MeesCode/gameboy-pcb/custom/models/wuerth_434133025816.stp

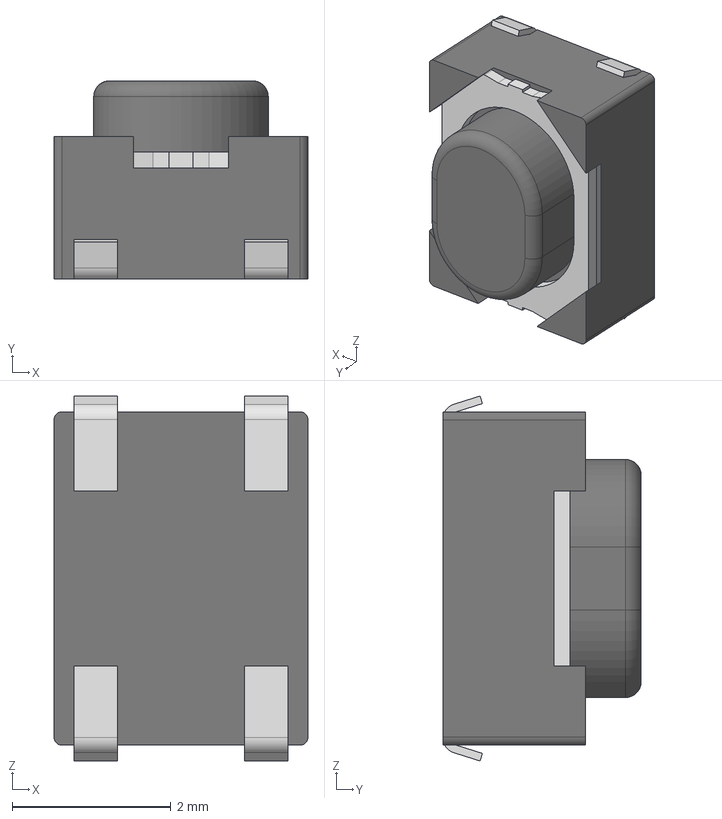
[picture p1: CAD file, 2026-01-30]
custom/models/wuerth_434133025816.stp
3.20 x 2.50 x 4.60 mm
Frame
Cover
Stem
Terminal x 4
