MeesCode/gameboy-pcb/gameboy.step

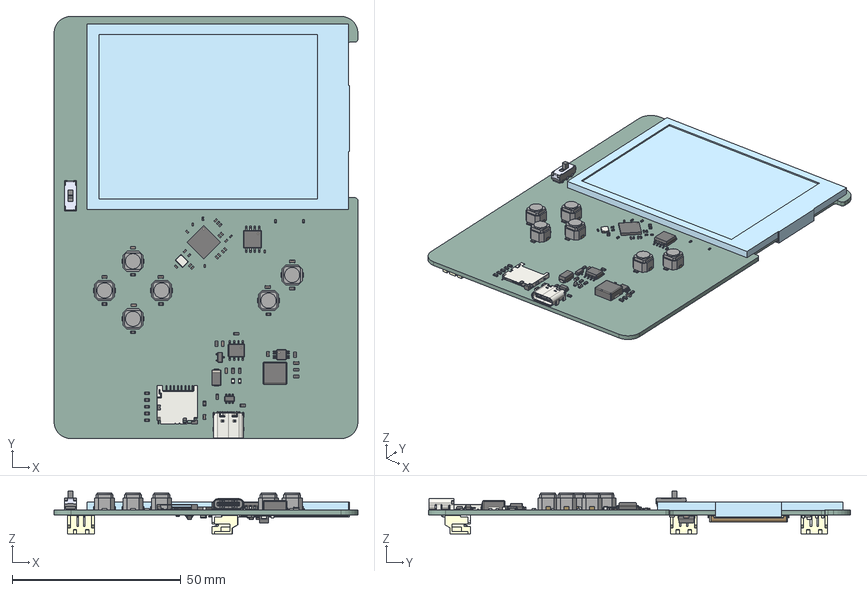
[picture p2: CAD file, 2026-01-30]
gameboy.step
90.0 x 125.0 x 12.7 mm
MSOP-8_3x3mm_P0.65mm
R_0402_1005Metric x 7
R_0603_1608Metric x 28
JS202011JCQN
C_0402_1005Metric x 17
C_0603_1608Metric x 16
pin_1 x 6
pin_2 x 6
SOIC-8_5.3x5.3mm_P1.27mm
LED_0603_1608Metric x 2
SO-8_3.9x4.9mm_P1.27mm
D_SMA x 2
QFN-56-1EP_7x7mm_P0.4mm_EP5.6x5.6mm
Crystal_SMD_3225-4Pin_3.2x2.5mm
microSD_HC_Hirose_DM3D-SF
USB_C_Receptacle_GCT_USB4105-xx-A_16P_TopMnt_Horizontal
SOT-23 x 3
SOT-23-6
L_KOHERelec_MDA7030
lock
pins
LCD
S2B-PH-SM4-TB x 3
L_0603_1608Metric x 2
C_0805_2012Metric
gameboy_PCB
