MeesCode/gameboy-pcb/custom/models/LDC.step

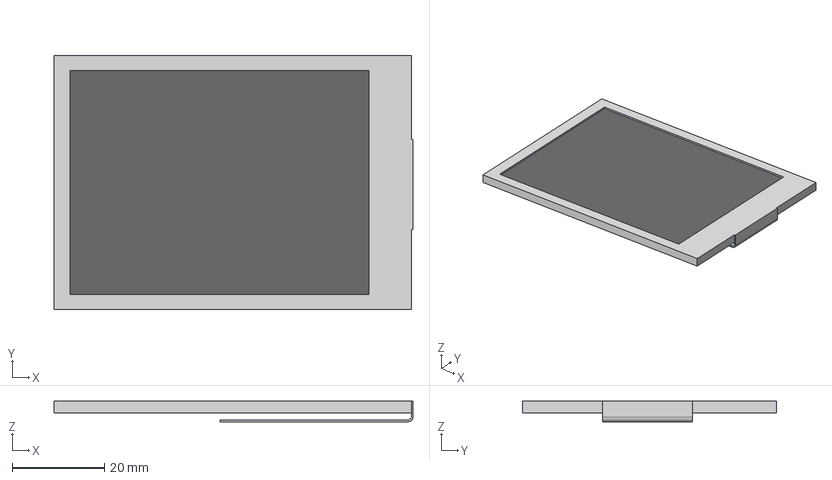
[picture p3: CAD file, 2026-01-30]
custom/models/LDC.step
77.8 x 55.0 x 4.45 mm
