MeesCode/gameboy-pcb/custom/models/SM03B-SRSS-TB_LF__SN_.stp

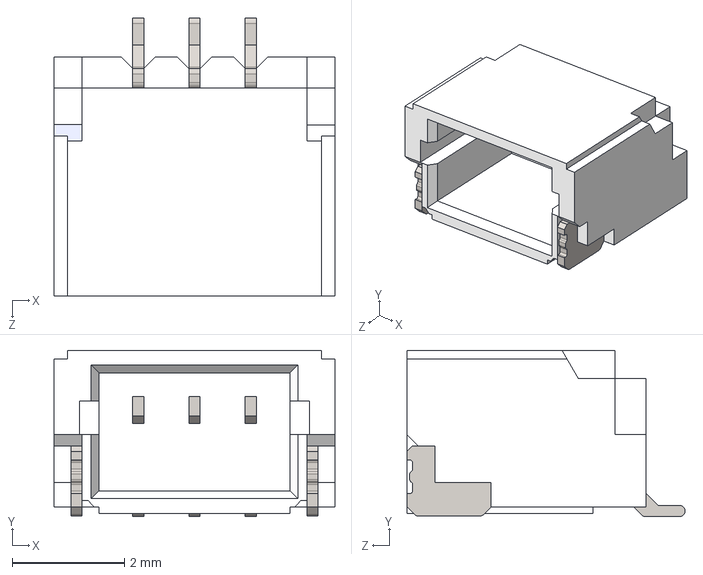
[picture p4: CAD file, 2026-01-30]
custom/models/SM03B-SRSS-TB_LF__SN_.stp
5.00 x 2.96 x 4.95 mm
