MeesCode/gameboy-pcb/custom/models/S2B-PH-SM4-TB.STEP

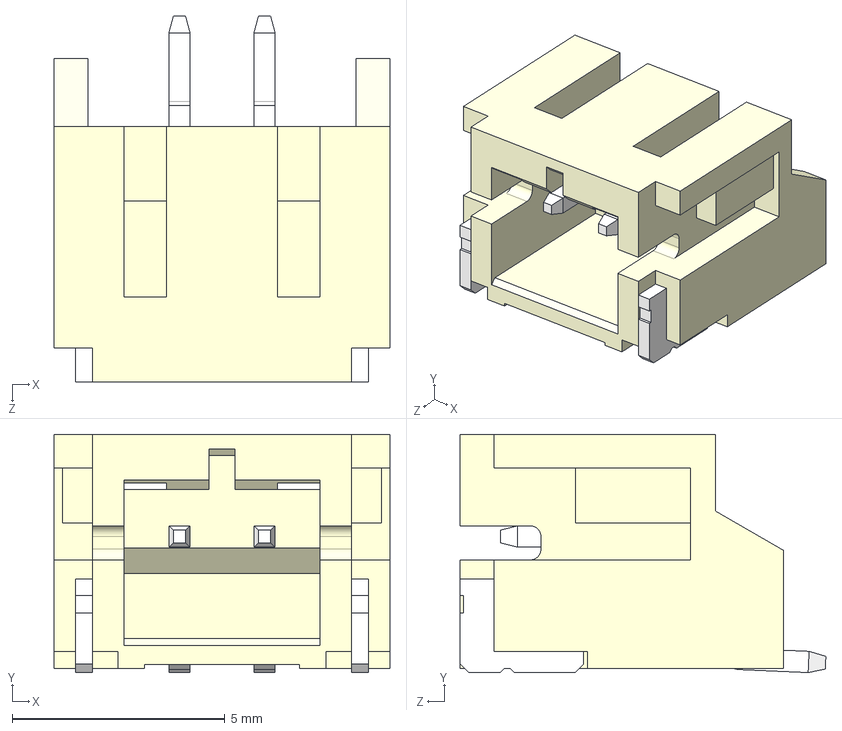
[picture p5: CAD file, 2026-01-20]
custom/models/S2B-PH-SM4-TB.STEP
7.90 x 5.60 x 8.60 mm
