MeesCode/gameboy-pcb/custom/models/RP2350_QFN60.step

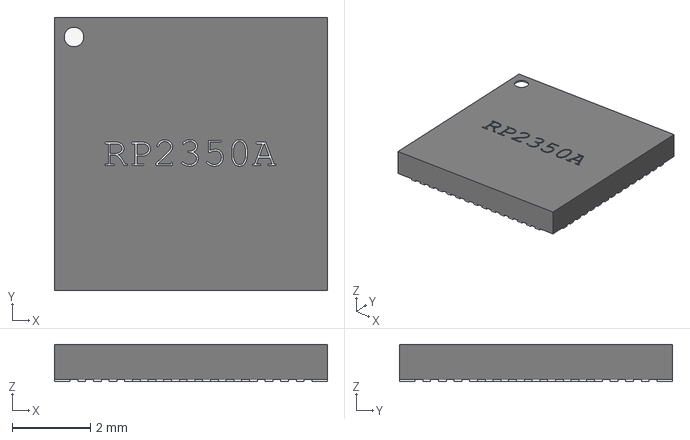
[picture p6: CAD file, 2026-01-10]
custom/models/RP2350_QFN60.step
7.00 x 7.00 x 0.95 mm
