MeesCode/gameboy-pcb/custom/models/SKRRAAE010.stp

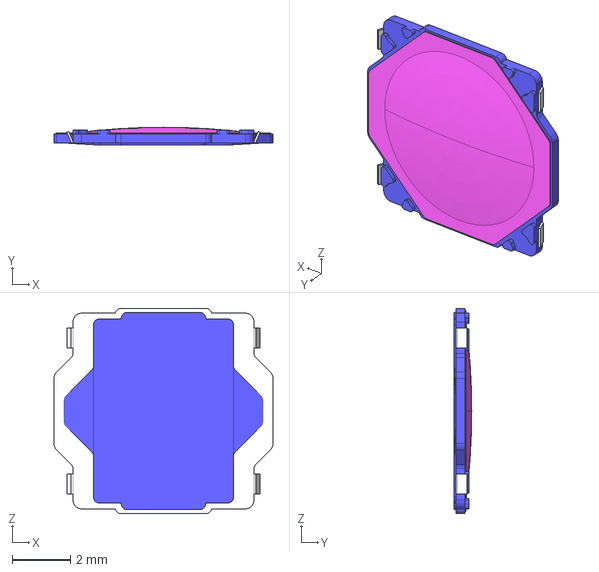
[picture p7: CAD file, 2025-12-01]
custom/models/SKRRAAE010.stp
7.50 x 0.6 x 7.03 mm
