MeesCode/gameboy-pcb/custom/models/JS202011JCQN.STEP

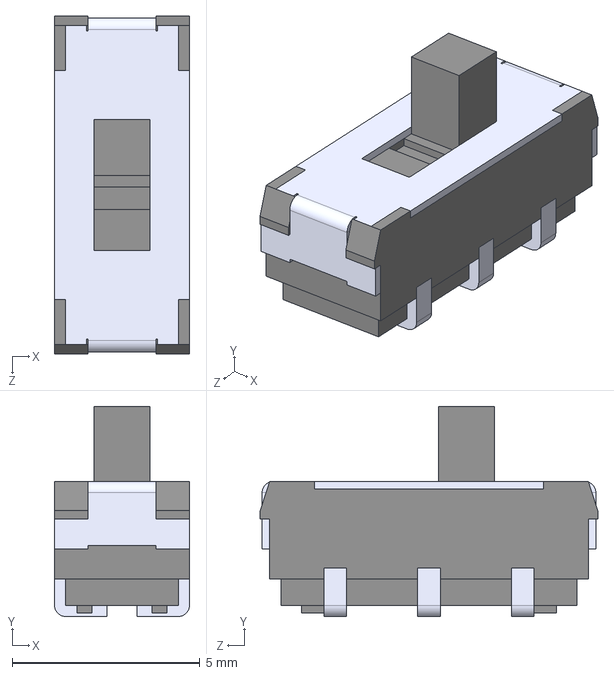
[picture p8: CAD file, 2026-01-30]
custom/models/JS202011JCQN.STEP
3.60 x 5.60 x 9.00 mm
