MeesCode/gameboy-pcb/gameboy.kicad_pcb

## KiCad design gameboy.kicad_pcb (2026-10-22)

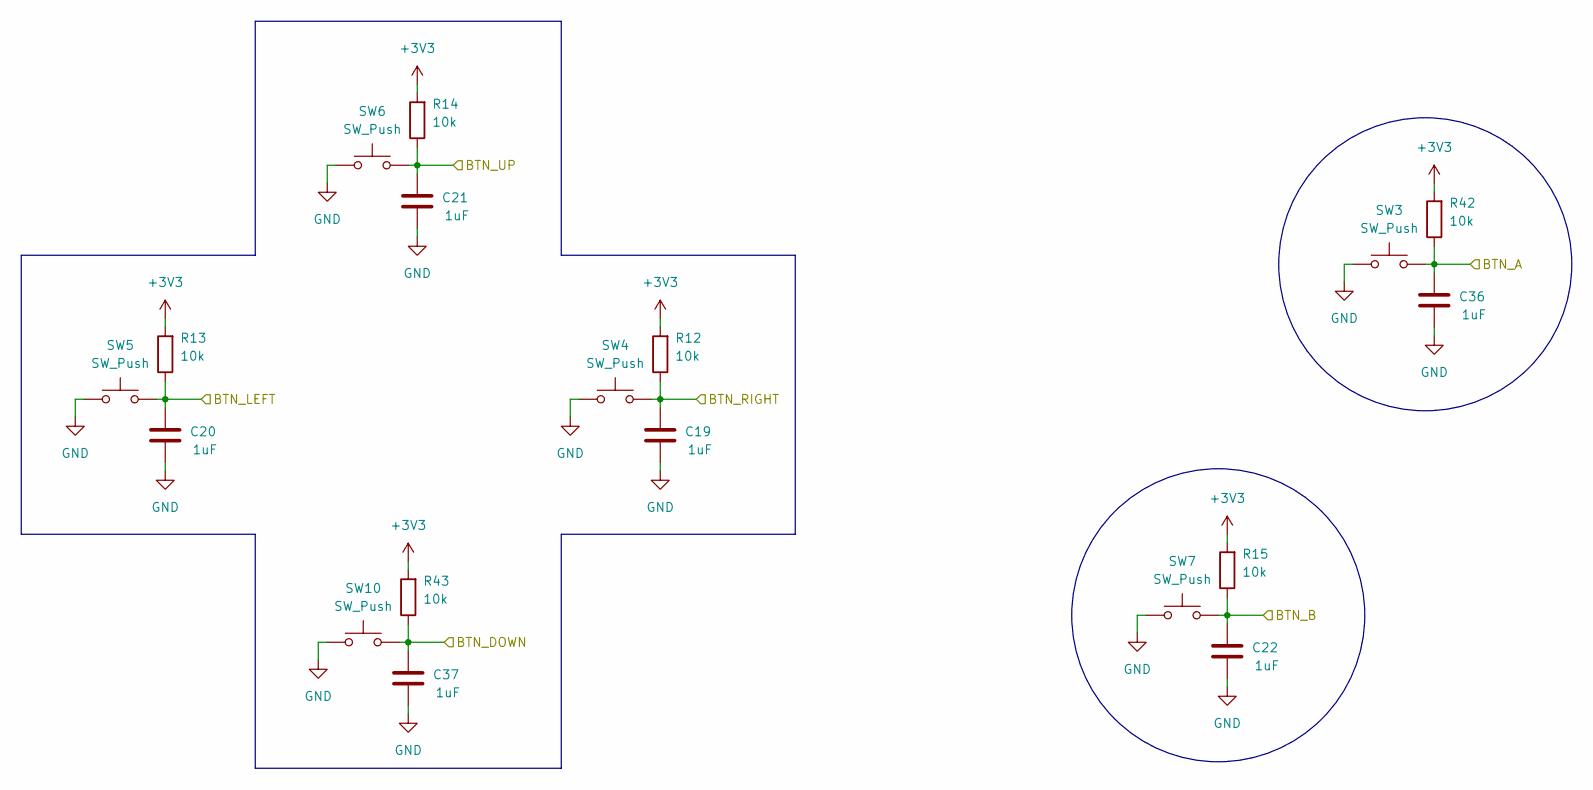
[picture p9: schematic buttons.kicad_sch]

Parts:
C19, C20, C21, C22, C36, C37: 1uF; C_0402_1005Metric; Manufacturer Part Number CL05A105KA5NQNC; LCSC C52923
R12, R13, R14, R15, R42, R43: 10k; R_0603_1608Metric
SW3, SW4, SW5, SW6, SW7, SW10: SW_Push; SW_Push_1TS009xxxx-xxxx-xxxx_6x6x5mm; Manufacturer Part Number HX TS665WS 200gf; LCSC C5143657

Connections:
+3V3: R12.2, R13.2, R14.2, R15.2, R42.2, R43.2; also elsewhere on the board
/Buttons/BTN_A: C36.2, R42.1, SW3.2; also elsewhere on the board
/Buttons/BTN_B: C22.2, R15.1, SW7.2; also elsewhere on the board
/Buttons/BTN_DOWN: C37.2, R43.1, SW10.2; also elsewhere on the board
/Buttons/BTN_LEFT: C20.2, R13.1, SW5.2; also elsewhere on the board
/Buttons/BTN_RIGHT: C19.2, R12.1, SW4.2; also elsewhere on the board
/Buttons/BTN_UP: C21.2, R14.1, SW6.2; also elsewhere on the board
GND: C19.1, C20.1, C21.1, C22.1, C36.1, C37.1, SW3.1, SW4.1, SW5.1, SW6.1, SW7.1, SW10.1; also elsewhere on the board

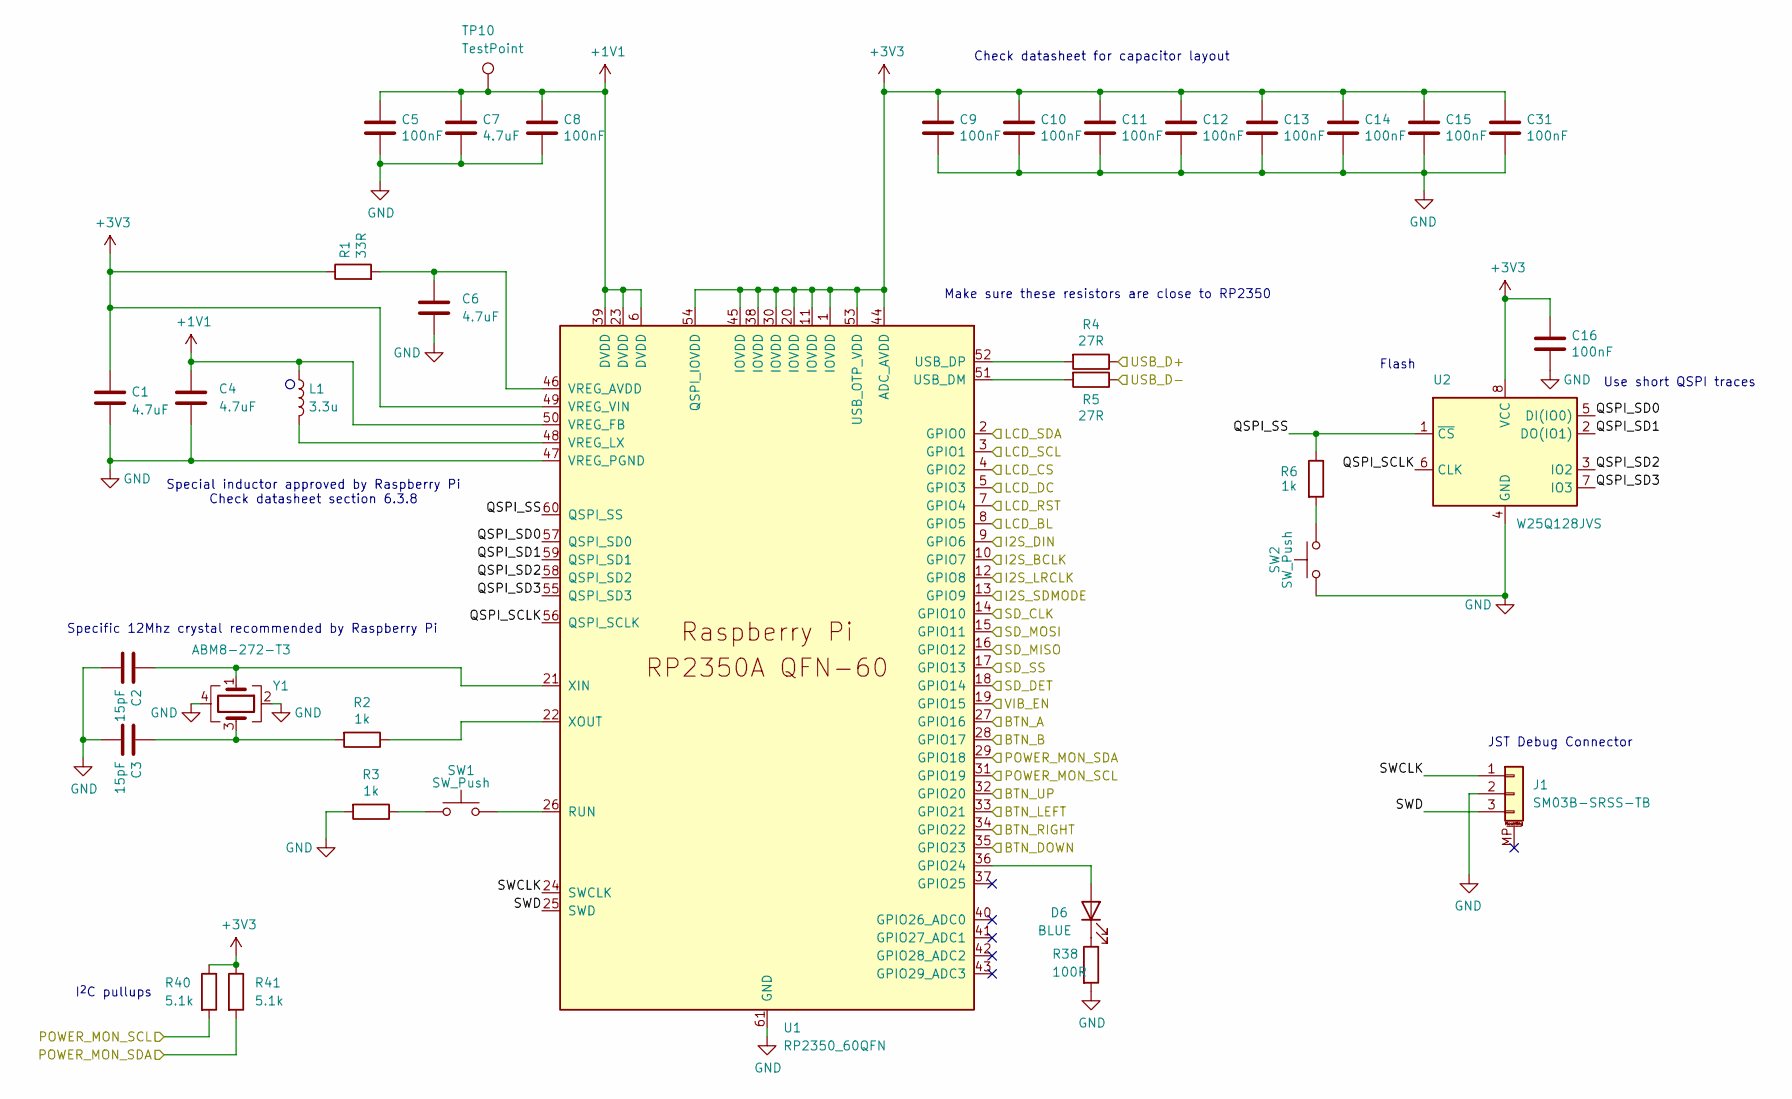
[picture p10: schematic mcu.kicad_sch]

Parts:
C1, C4, C6, C7: 4.7uF; C_0402_1005Metric
C2, C3: 15pF; C_0402_1005Metric
C5, C8, C9, C10, C11, C12, C13, C14, C15, C16, C31: 100nF; C_0402_1005Metric
D6: BLUE; LED_Sideways; Manufacturer Part Number XL-1606UBC; LCSC C965865
J1: SM03B-SRSS-TB; JST_SH_SM03B-SRSS-TB_1x03-1MP_P1.00mm_Horizontal; LCSC C160403
L1: 3.3u; L_pol_2016; Manufacturer Part Number AOTA-B201610S3R3-101-T; LCSC C42411119
R1: 33R; R_0402_1005Metric
R2, R3, R6: 1k; R_0603_1608Metric
R4, R5: 27R; R_0402_1005Metric
R38: 100R; R_0603_1608Metric; Manufacturer Part Number 0603WAF1000T5E; LCSC C22775
R40, R41: 5.1k; R_0603_1608Metric
SW1, SW2: SW_Push; SW_Push_1P1T_NO_Vertical_Wuerth_434133025816; Manufacturer Part Number 434133025816; LCSC C843674
TP10: TestPoint; TestPoint_Pad_D1.0mm
U1: RP2350_60QFN; RP2350-QFN-60-1EP_7x7_P0.4mm_EP3.4x3.4mm_ThermalVias; Manufacturer Part Number RP2350A; LCSC C42411118
U2: W25Q128JVS; SOIC-8_5.3x5.3mm_P1.27mm; Manufacturer Part Number W25Q128JVSIQ; LCSC C113767
Y1: ABM8-272-T3; Crystal_SMD_3225-4Pin_3.2x2.5mm; Manufacturer Part Number ABM8-272-T3; LCSC C20625731

Connections:
+1V1: C4.1, C5.1, C7.1, C8.1, L1.1, TP10.1 (1_1), U1.6 (DVDD), U1.23 (DVDD), U1.39 (DVDD), U1.50 (VREG_FB)
+3V3: C1.1, C9.1, C10.1, C11.1, C12.1, C13.1, C14.1, C15.1, C16.1, C31.1, R1.1, R40.1, R41.1, U1.1 (IOVDD), U1.11 (IOVDD), U1.20 (IOVDD), U1.30 (IOVDD), U1.38 (IOVDD), U1.44 (ADC_AVDD), U1.45 (IOVDD), U1.49 (VREG_VIN), U1.53 (USB_OTP_VDD), U1.54 (QSPI_IOVDD), U2.8 (VCC); also elsewhere on the board
/Audio/I2S_BCLK: U1.10 (GPIO7); also elsewhere on the board
/Audio/I2S_DIN: U1.9 (GPIO6); also elsewhere on the board
/Audio/I2S_LRCLK: U1.12 (GPIO8); also elsewhere on the board
/Audio/I2S_SDMODE: U1.13 (GPIO9); also elsewhere on the board
/Buttons/BTN_A: U1.27 (GPIO16); also elsewhere on the board
/Buttons/BTN_B: U1.28 (GPIO17); also elsewhere on the board
/Buttons/BTN_DOWN: U1.35 (GPIO23); also elsewhere on the board
/Buttons/BTN_LEFT: U1.33 (GPIO21); also elsewhere on the board
/Buttons/BTN_RIGHT: U1.34 (GPIO22); also elsewhere on the board
/Buttons/BTN_UP: U1.32 (GPIO20); also elsewhere on the board
/LCD/LCD_BL: U1.8 (GPIO5); also elsewhere on the board
/LCD/LCD_CS: U1.4 (GPIO2); also elsewhere on the board
/LCD/LCD_DC: U1.5 (GPIO3); also elsewhere on the board
/LCD/LCD_RST: U1.7 (GPIO4); also elsewhere on the board
/LCD/LCD_SCL: U1.3 (GPIO1); also elsewhere on the board
/LCD/LCD_SDA: U1.2 (GPIO0); also elsewhere on the board
/MCU/POWER_MON_SCL: R40.2, U1.31 (GPIO19); also elsewhere on the board
/MCU/POWER_MON_SDA: R41.2, U1.29 (GPIO18); also elsewhere on the board
/MCU/QSPI_SCLK: U1.56 (QSPI_SCLK), U2.6 (CLK)
/MCU/QSPI_SD0: U1.57 (QSPI_SD0), U2.5 (DI(IO0))
/MCU/QSPI_SD1: U1.59 (QSPI_SD1), U2.2 (DO(IO1))
/MCU/QSPI_SD2: U1.58 (QSPI_SD2), U2.3 (IO2)
/MCU/QSPI_SD3: U1.55 (QSPI_SD3), U2.7 (IO3)
/MCU/QSPI_SS: R6.1, U1.60 (QSPI_SS), U2.1 (~CS)
/MCU/SD_CLK: U1.14 (GPIO10); also elsewhere on the board
/MCU/SD_DET: U1.18 (GPIO14); also elsewhere on the board
/MCU/SD_MISO: U1.16 (GPIO12); also elsewhere on the board
/MCU/SD_MOSI: U1.15 (GPIO11); also elsewhere on the board
/MCU/SD_SS: U1.17 (GPIO13); also elsewhere on the board
/MCU/SWCLK: J1.1, U1.24 (SWCLK)
/MCU/SWD: J1.3, U1.25 (SWD)
/MCU/USB_D+: R4.1; also elsewhere on the board
/MCU/USB_D-: R5.1; also elsewhere on the board
/MCU/VIB_EN: U1.19 (GPIO15); also elsewhere on the board
GND: C1.2, C2.2, C3.2, C4.2, C5.2, C6.2, C7.2, C8.2, C9.2, C10.2, C11.2, C12.2, C13.2, C14.2, C15.2, C16.2, C31.2, J1.2, R3.2, R38.2, SW2.1, U1.47 (VREG_PGND), U1.61 (GND), U2.4 (GND), Y1.2, Y1.4; also elsewhere on the board
unnamed: C3.1, R2.2, Y1.3
unnamed: D6.2 (A), U1.36 (GPIO24)
unnamed: D6.1 (K), R38.1
unnamed: R3.1, SW1.1
unnamed: R6.2, SW2.2
unnamed: SW1.2, U1.26 (RUN)
unnamed: R5.2, U1.51 (USB_DM)
unnamed: R4.2, U1.52 (USB_DP)
unnamed: C6.1, R1.2, U1.46 (VREG_AVDD)
unnamed: L1.2, U1.48 (VREG_LX)
unnamed: C2.1, U1.21 (XIN), Y1.1
unnamed: R2.1, U1.22 (XOUT)

Notes on the sheet:
Check datasheet for capacitor layout
Special inductor approved by Raspberry Pi Check datasheet section 6.3.8
Specific 12Mhz crystal recommended by Raspberry Pi
Use short QSPI traces
Make sure these resistors are close to RP2350
Flash
I^{2}C pullups
JST Debug Connector

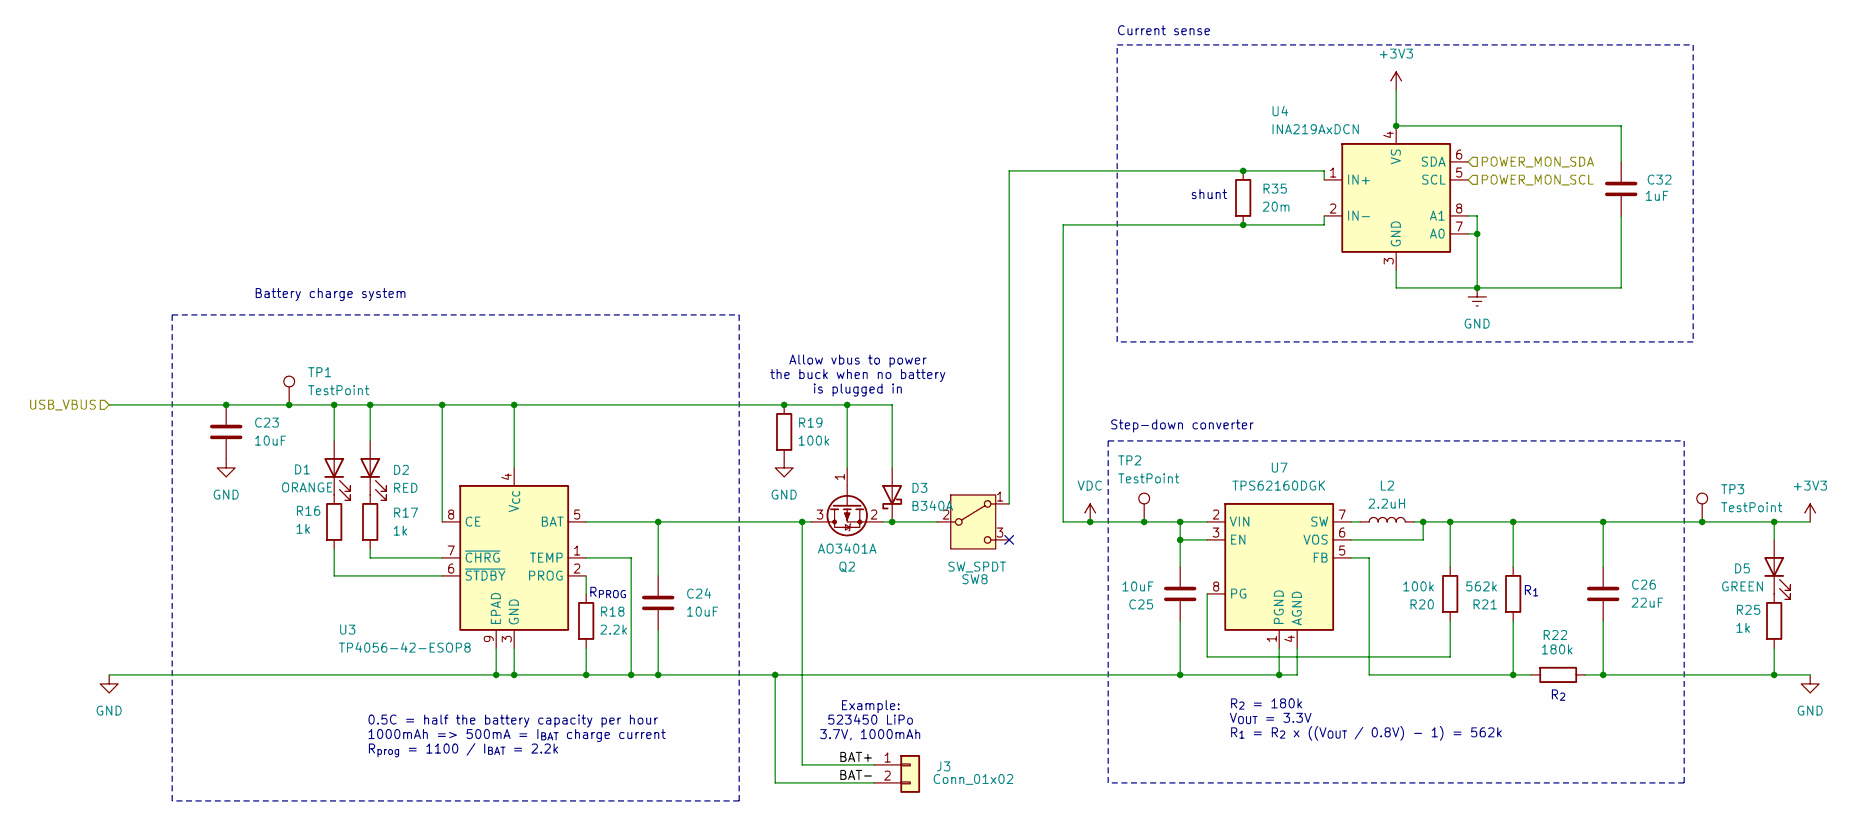
[picture p11: schematic power.kicad_sch]

Parts:
C23, C24, C25: 10uF; C_0805_2012Metric
C26: 22uF; C_0603_1608Metric
C32: 1uF; C_0402_1005Metric; Manufacturer Part Number CL05A105KA5NQNC; LCSC C52923
D1: ORANGE; LED_Sideways; Manufacturer Part Number XL-1606UOC; LCSC C965861
D2: RED; LED_Sideways; Manufacturer Part Number XL-1606SURC; LCSC C965860
D3: B340A; D_SMA; Manufacturer Part Number B340A; LCSC C64982
D5: GREEN; LED_Sideways; Manufacturer Part Number XL-1606SYGC; LCSC C965864
J3: Conn_01x02; JST_PH_S2B-PH-SM4-TB_1x02-1MP_P2.00mm_Horizontal; Manufacturer Part Number S2B-PH-SM4-TB(LF)(SN); LCSC C295747
L2: 2.2uH; L_KOHERelec_MDA7030; Manufacturer Part Number APH0630T2R2M; LCSC C5349701
Q2: AO3401A; SOT-23; Manufacturer Part Number AO3401A; LCSC C347476
R16, R17, R25: 1k; R_0603_1608Metric
R18: 2.2k; R_0603_1608Metric
R19, R20: 100k; R_0603_1608Metric
R21: 562k; R_0603_1608Metric
R22: 180k; R_0603_1608Metric
R35: 20m; R_1206_3216Metric; LCSC C393094
SW8: SW_SPDT; SW_SPDT_CK_JS102011SAQN; Manufacturer Part Number JS102011SAQN; LCSC C221660
TP1, TP2, TP3: TestPoint; TestPoint_Pad_D1.0mm
U3: TP4056-42-ESOP8; SOIC-8-1EP_3.9x4.9mm_P1.27mm_EP2.41x3.3mm_ThermalVias; Manufacturer Part Number TP4056-42-ESOP8; LCSC C16581
U4: INA219AxDCN; SOT-23-8; LCSC C87469
U7: TPS62160DGK; MSOP-8_3x3mm_P0.65mm; Manufacturer Part Number TPS62160DGKR; LCSC C60726

Connections:
+3V3: C26.1, C32.2, D5.2 (A), L2.2, R20.1, R21.1, TP3.1 (1_1), U4.4 (VS), U7.6 (VOS); also elsewhere on the board
/MCU/POWER_MON_SCL: U4.5 (SCL); also elsewhere on the board
/MCU/POWER_MON_SDA: U4.6 (SDA); also elsewhere on the board
/Power/BAT+: C24.1, J3.1, Q2.3 (D), U3.5 (BAT)
/Power/USB_VBUS: C23.1, D1.2 (A), D2.2 (A), D3.2 (A), Q2.1 (G), R19.1, TP1.1 (1_1), U3.4 (V_{CC}), U3.8 (CE); also elsewhere on the board
GND: C23.2, C24.2, C25.2, C26.2, C32.1, J3.2, R18.2, R19.2, R22.1, R25.2, U3.1 (TEMP), U3.3 (GND), U3.9 (EPAD), U4.3 (GND), U4.7 (A0), U4.8 (A1), U7.1 (PGND), U7.4 (AGND); also elsewhere on the board
unnamed: D1.1 (K), R16.1
unnamed: D2.1 (K), R17.1
unnamed: D3.1 (K), Q2.2 (S), SW8.2 (B)
unnamed: D5.1 (K), R25.1
unnamed: R35.1, SW8.1 (A), U4.1 (IN+)
unnamed: R18.1, U3.2 (PROG)
unnamed: R17.2, U3.7 (~CHRG)
unnamed: R16.2, U3.6 (~STDBY)
unnamed: R21.2, R22.2, U7.5 (FB)
unnamed: R20.2, U7.8 (PG)
unnamed: L2.1, U7.7 (SW)
VDC: C25.1, R35.2, TP2.1 (1_1), U4.2 (IN-), U7.2 (VIN), U7.3 (EN)

Notes on the sheet:
shunt
Example: 523450 LiPo 3.7V, 1000mAh
R_{1}
Current sense
R_{2} = 180k V_{OUT} = 3.3V R_{1} = R_{2} x ((V_{OUT} / 0.8V) - 1) = 562k
Battery charge system
R_{PROG}
0.5C = half the battery capacity per hour 1000mAh => 500mA = I_{BAT} charge current R_{prog} = 1100 / I_{BAT} = 2.2k
Allow vbus to power the buck when no battery is plugged in
R_{2}
Step-down converter

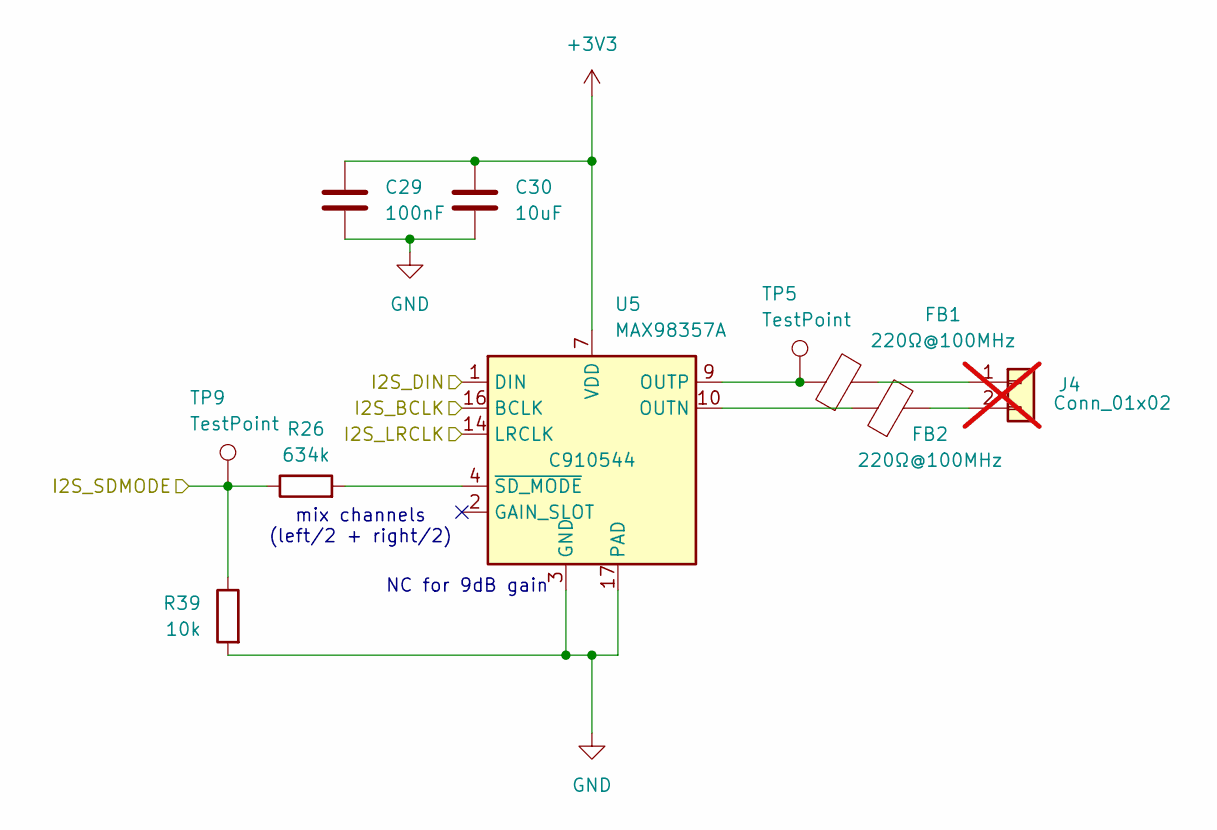
[picture p12: schematic audio.kicad_sch]

Parts:
C29: 100nF; C_0603_1608Metric
C30: 10uF; C_0805_2012Metric
FB1, FB2: 220Ω@100MHz; L_0603_1608Metric; Manufacturer Part Number MPZ1608S221ATA00; LCSC C76815
J4: Conn_01x02; JST_PH_S2B-PH-SM4-TB_1x02-1MP_P2.00mm_Horizontal; Manufacturer Part Number S2B-PH-SM4-TB(LF)(SN); LCSC C295747; not fitted
R26: 634k; R_0603_1608Metric; LCSC C2999499
R39: 10k; R_0603_1608Metric
TP5, TP9: TestPoint; TestPoint_Pad_D1.0mm
U5: MAX98357A; TQFN-16-1EP_3x3mm_P0.5mm_EP1.23x1.23mm; LCSC C910544

Connections:
+3V3: C29.1, C30.1, U5.7 (VDD), U5.8 (VDD); also elsewhere on the board
/Audio/I2S_BCLK: U5.16 (BCLK); also elsewhere on the board
/Audio/I2S_DIN: U5.1 (DIN); also elsewhere on the board
/Audio/I2S_LRCLK: U5.14 (LRCLK); also elsewhere on the board
/Audio/I2S_SDMODE: R26.1, R39.1, TP9.1 (1_1); also elsewhere on the board
GND: C29.2, C30.2, R39.2, U5.3 (GND), U5.11 (GND), U5.15 (GND), U5.17 (PAD); also elsewhere on the board
unnamed: FB1.2, J4.1
unnamed: FB2.2, J4.2
unnamed: FB2.1, U5.10 (OUTN)
unnamed: FB1.1, TP5.1 (1_1), U5.9 (OUTP)
unnamed: R26.2, U5.4 (~SD_MODE)

Notes on the sheet:
mix channels (left/2 + right/2)
NC for 9dB gain

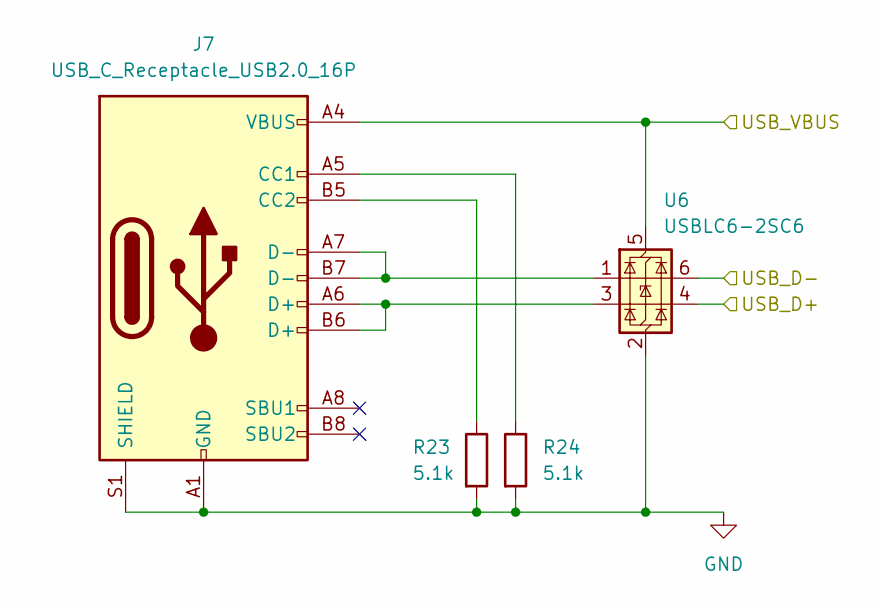
[picture p13: schematic usb.kicad_sch]

Parts:
J7: USB_C_Receptacle_USB2.0_16P; USB_C_Receptacle_GCT_USB4105-xx-A_16P_TopMnt_Horizontal; Manufacturer Part Number TYPE-C 16PIN 2MD(073); LCSC C2765186
R23, R24: 5.1k; R_0603_1608Metric
U6: USBLC6-2SC6; SOT-23-6; Manufacturer Part Number USBLC6-2SC6; LCSC C2827654

Connections:
/MCU/USB_D+: U6.4 (I/O2); also elsewhere on the board
/MCU/USB_D-: U6.6 (I/O1); also elsewhere on the board
/Power/USB_VBUS: J7.A4 (VBUS), J7.A9 (VBUS), J7.B4 (VBUS), J7.B9 (VBUS), U6.5 (VBUS); also elsewhere on the board
GND: J7.A1 (GND), J7.A12 (GND), J7.B1 (GND), J7.B12 (GND), J7.S1 (SHIELD), R23.2, R24.2, U6.2 (GND); also elsewhere on the board
unnamed: J7.A5 (CC1), R24.1
unnamed: J7.B5 (CC2), R23.1
unnamed: J7.A6 (D+), J7.B6 (D+), U6.3 (I/O2)
unnamed: J7.A7 (D-), J7.B7 (D-), U6.1 (I/O1)

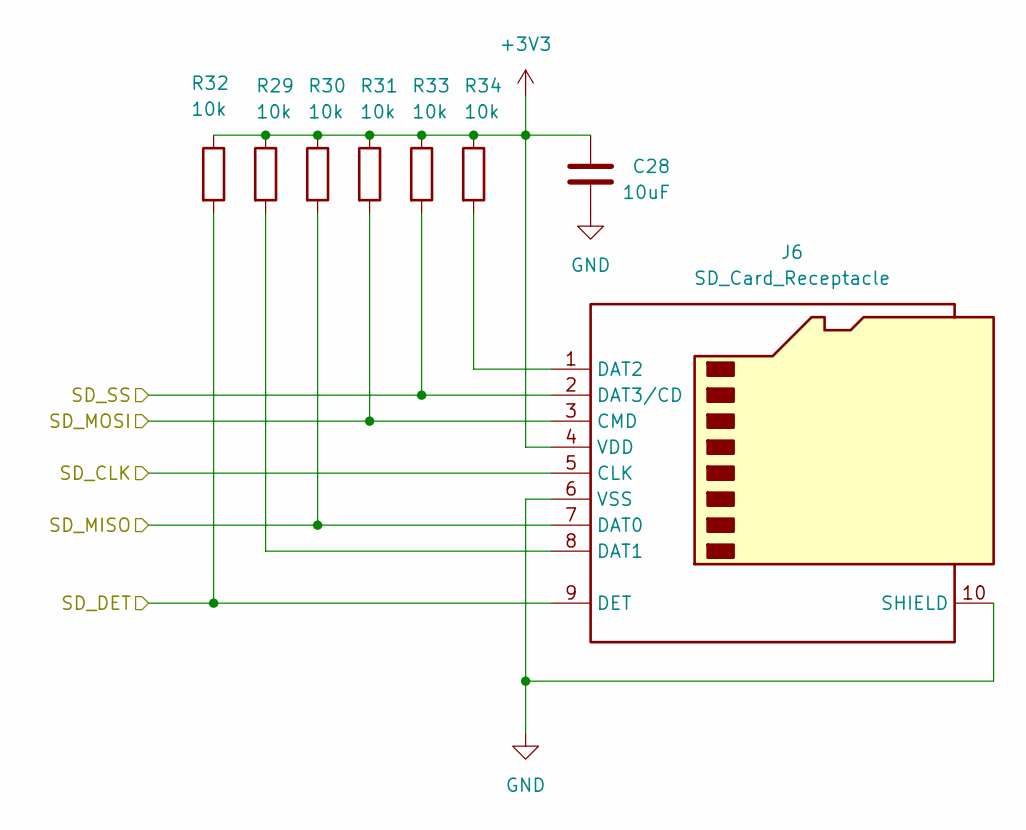
[picture p14: schematic sd.kicad_sch]

Parts:
C28: 10uF; C_0805_2012Metric
J6: SD_Card_Receptacle; SHOU HAN; Manufacturer Part Number TF PUSH; LCSC C393941
R29, R30, R31, R32, R33, R34: 10k; R_0603_1608Metric

Connections:
+3V3: C28.1, J6.4 (VDD), R29.1, R30.1, R31.1, R32.1, R33.1, R34.1; also elsewhere on the board
/MCU/SD_CLK: J6.5 (CLK); also elsewhere on the board
/MCU/SD_DET: J6.9 (DET), R32.2; also elsewhere on the board
/MCU/SD_MISO: J6.7 (DAT0), R30.2; also elsewhere on the board
/MCU/SD_MOSI: J6.3 (CMD), R31.2; also elsewhere on the board
/MCU/SD_SS: J6.2 (DAT3/CD), R33.2; also elsewhere on the board
GND: C28.2, J6.6 (VSS), J6.10 (SHIELD); also elsewhere on the board
unnamed: J6.8 (DAT1), R29.2
unnamed: J6.1 (DAT2), R34.2

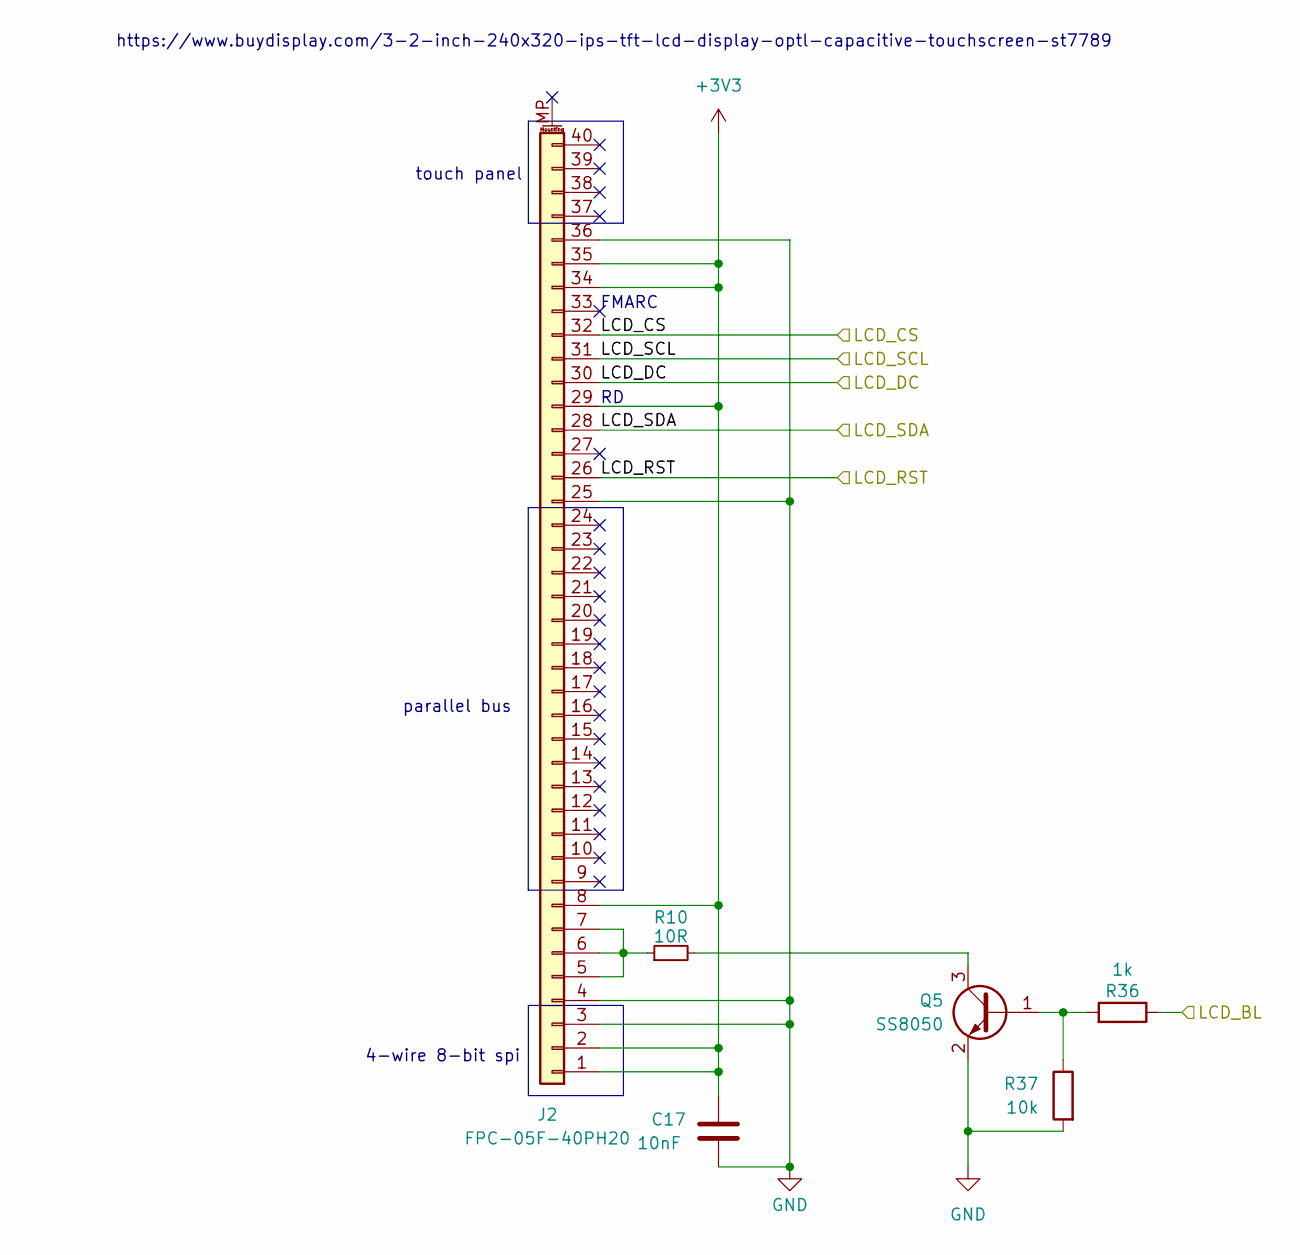
[picture p15: schematic lcd.kicad_sch]

Parts:
C17: 10nF; C_0402_1005Metric
J2: FPC-05F-40PH20; TE_4-1734839-0_1x40-1MP_P0.5mm_Horizontal; Manufacturer Part Number AFC07-S40ECA-00; LCSC C262648
Q5: SS8050; SOT-23; Manufacturer Part Number SS8050; LCSC C916392
R10: 10R; R_0603_1608Metric
R36: 1k; R_0603_1608Metric
R37: 10k; R_0603_1608Metric

Connections:
+3V3: C17.2, J2.1, J2.2, J2.8, J2.29, J2.34, J2.35; also elsewhere on the board
/LCD/LCD_BL: R36.1; also elsewhere on the board
/LCD/LCD_CS: J2.32; also elsewhere on the board
/LCD/LCD_DC: J2.30; also elsewhere on the board
/LCD/LCD_RST: J2.26; also elsewhere on the board
/LCD/LCD_SCL: J2.31; also elsewhere on the board
/LCD/LCD_SDA: J2.28; also elsewhere on the board
GND: C17.1, J2.3, J2.4, J2.25, J2.36, Q5.2 (E), R37.2; also elsewhere on the board
unnamed: J2.5, J2.6, J2.7, R10.1
unnamed: Q5.1 (B), R36.2, R37.1
unnamed: Q5.3 (C), R10.2

Notes on the sheet:
https://www.buydisplay.com/3-2-inch-240x320-ips-tft-lcd-display-optl-capacitive-touchscreen-st7789
parallel bus
FMARC
4-wire 8-bit spi
touch panel

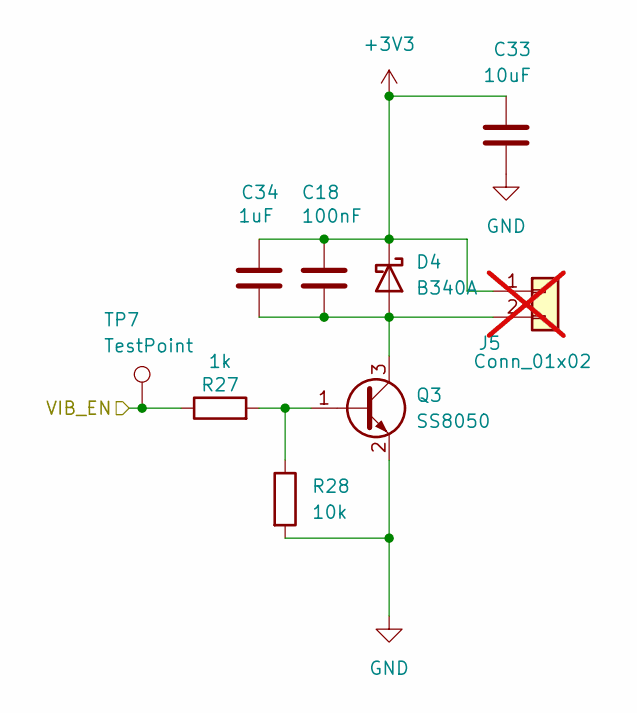
[picture p16: schematic vibration.kicad_sch]

Parts:
C18: 100nF; C_0402_1005Metric
C33: 10uF; C_0805_2012Metric
C34: 1uF; C_0402_1005Metric; Manufacturer Part Number CL05A105KA5NQNC; LCSC C52923
D4: B340A; D_SMA; Manufacturer Part Number B340A; LCSC C64982
J5: Conn_01x02; JST_PH_S2B-PH-SM4-TB_1x02-1MP_P2.00mm_Horizontal; Manufacturer Part Number S2B-PH-SM4-TB(LF)(SN); LCSC C295747; not fitted
Q3: SS8050; SOT-23; Manufacturer Part Number SS8050; LCSC C916392
R27: 1k; R_0603_1608Metric
R28: 10k; R_0603_1608Metric
TP7: TestPoint; TestPoint_Pad_D1.0mm

Connections:
+3V3: C18.1, C33.1, C34.2, D4.1 (K), J5.1; also elsewhere on the board
/MCU/VIB_EN: R27.1, TP7.1 (1_1); also elsewhere on the board
GND: C33.2, Q3.2 (E), R28.2; also elsewhere on the board
unnamed: C18.2, C34.1, D4.2 (A), J5.2, Q3.3 (C)
unnamed: Q3.1 (B), R27.2, R28.1

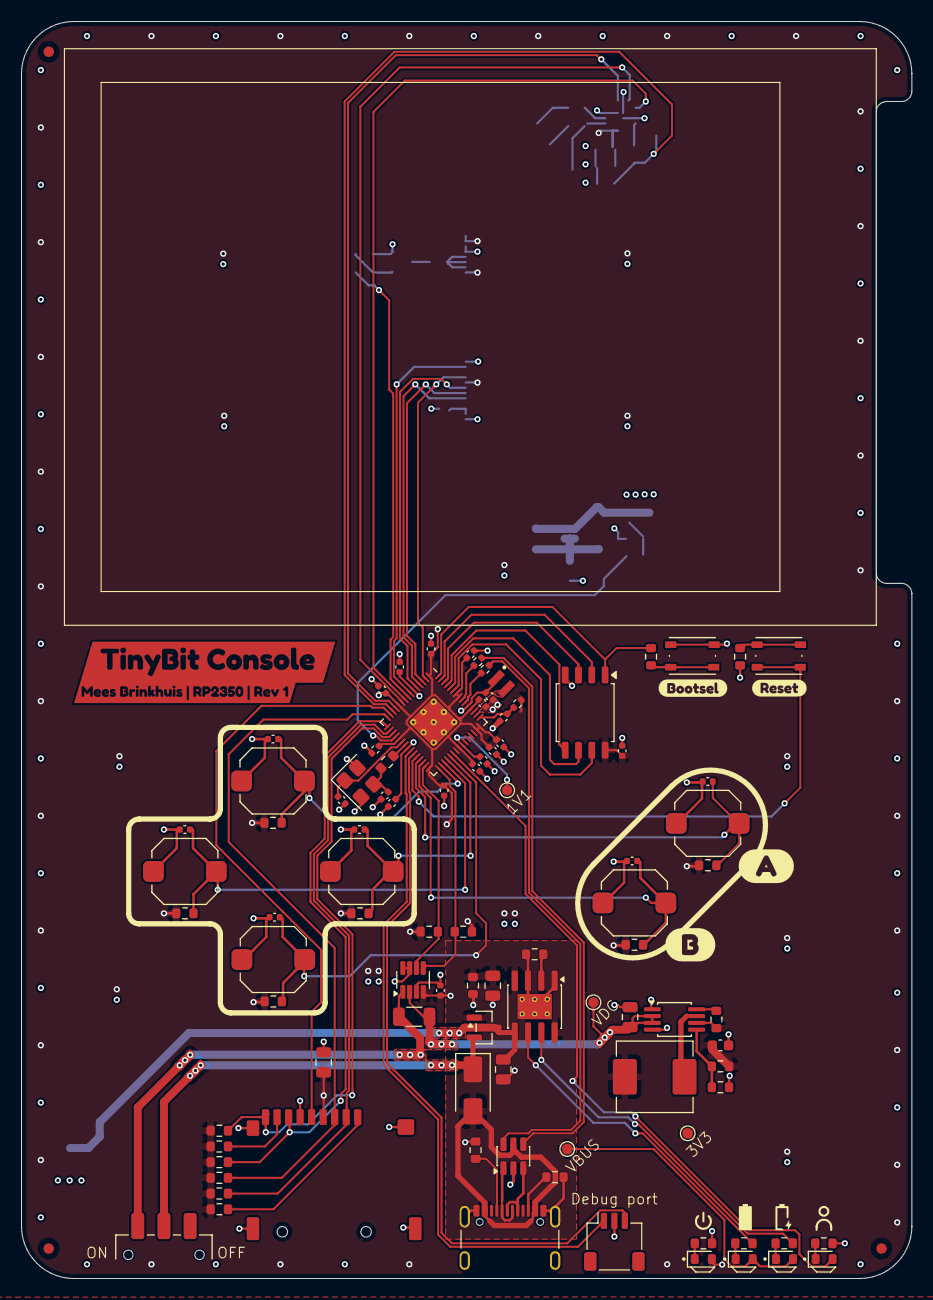
[picture p17: board gameboy.kicad_pcb from above]

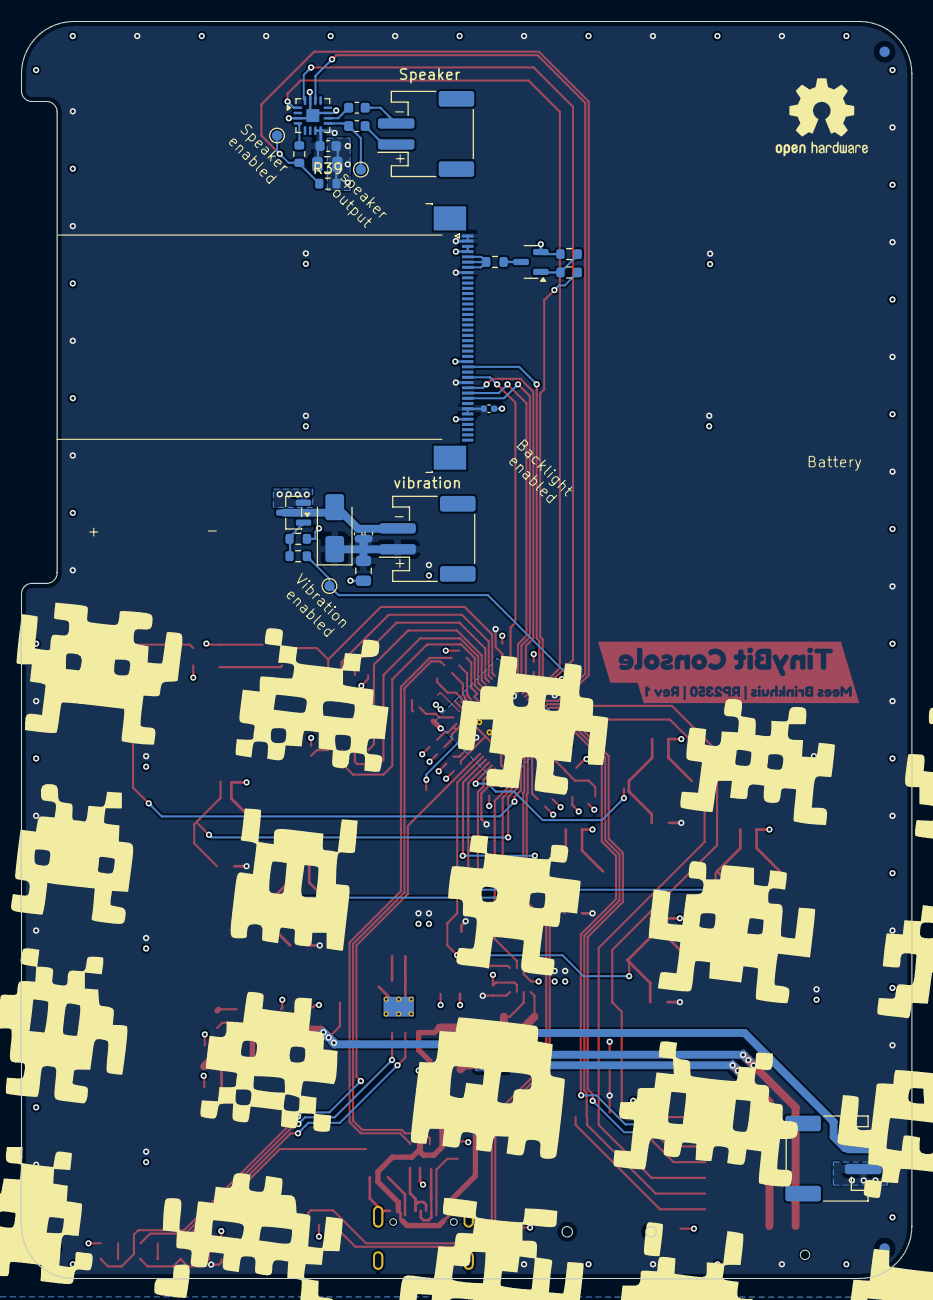
[picture p18: board gameboy.kicad_pcb from below]

Board: 4 copper layers, 85.0 x 120.0 mm, 124 parts (26 on the bottom side), 79 nets.

Other parts of the board:
kibuzzard-6ABF64DD: G***; kibuzzard-6ABF64DD
kibuzzard-6ABF6516: G***; kibuzzard-6ABF6516
kibuzzard-6975FF76: G***; kibuzzard-6975FF76
kibuzzard-6973473F: G***; kibuzzard-6973473F
kibuzzard-69734758: G***; kibuzzard-69734758
kibuzzard-69734789: G***; kibuzzard-69734789
