MeesCode/gameboy-pcb/gameboy.ioc

Mcu.UserName=STM32F722RCTx
PA0-WKUP.GPIO_Label=VCP_TX
PA0-WKUP.Signal=UART4_TX
PA1.GPIO_Label=VCP_RX
PA1.Signal=UART4_RX
PA5.Signal=SPI1_SCK
PA7.Signal=SPI1_MOSI
PC10.Signal=SDMMC1_D2
PC11.Signal=SDMMC1_D3
PC12.Signal=SDMMC1_CK
PC8.Signal=SDMMC1_D0
PC9.Signal=SDMMC1_D1
PD2.Signal=SDMMC1_CMD
PH0-OSC_IN.Signal=RCC_OSC_IN
PH1-OSC_OUT.Signal=RCC_OSC_OUT
