MeesCode/gameboy-pcb/(commit log)

2025-11-30 start with power management
    [gameboy.kicad_sch, power.kicad_sch]
2025-11-30 finish power management
    [power.kicad_sch]
2025-11-30 led driver backlight, not finished
    [gameboy.kicad_sch, power.kicad_sch]
2025-12-01 add buttons and connect lcd
    [SKRRAAE010.stl, SKRRAAE010.stp, buttons.kicad_sch, gameboy.kicad_sch, lcd.kicad_sch, power.kicad_sch]
2025-12-01 button debouncing and VDD decoupling
    [buttons.kicad_sch, gameboy.kicad_sch]
2026-01-09 remove backups, removed old chip
    [gameboy.kicad_pcb, gameboy.kicad_sch, lcd.kicad_sch, power.kicad_sch]
2026-01-10 add rp2350 mcu
    [RP2350_QFN60.step, gameboy.kicad_pcb, gameboy.kicad_sch, mcu.kicad_sch, power.kicad_sch]
2026-01-10 add usb c connector
    [mcu.kicad_sch, power.kicad_sch]
2026-01-11 schematic functional and includes current test setup
    [buttons.kicad_sch, gameboy.kicad_sch, lcd.kicad_sch, mcu.kicad_sch, power.kicad_sch, usb.kicad_sch]
2026-01-11 add audio amp
    [audio.kicad_sch, gameboy.kicad_sch, lcd.kicad_sch, mcu.kicad_sch, usb.kicad_sch]
2026-01-12 add amplifier mode selector, add drawing lcd
    [audio.kicad_sch, buttons.kicad_sch, gameboy.kicad_pcb, gameboy.kicad_sch, lcd.kicad_sch, mcu.kicad_sch, usb.kicad_sch]
2026-01-12 add on/off switch
    [audio.kicad_sch, lcd.kicad_sch, usb.kicad_sch]
2026-01-12 add vibration motor
    [gameboy.kicad_sch, mcu.kicad_sch, usb.kicad_sch, vibration.kicad_sch]
2026-01-12 add SD card
    [audio.kicad_sch, gameboy.kicad_pcb, gameboy.kicad_sch, lcd.kicad_sch, mcu.kicad_sch, sd.kicad_sch, usb.kicad_sch, vibration.kicad_sch]
2026-01-12 small updates in component selection
    [gameboy.kicad_pcb, lcd.kicad_sch, usb.kicad_sch, vibration.kicad_sch]
2026-01-13 check with hardware manual, add comments, add mpns
    [buttons.kicad_sch, gameboy.kicad_sch, lcd.kicad_sch, mcu.kicad_sch, usb.kicad_sch, usbconn.kicad_sch]
2026-01-14 fix usb and add esd diodes, some other checks
    [audio.kicad_sch, buttons.kicad_sch, gameboy.kicad_pcb, lcd.kicad_sch, power.kicad_sch, sd.kicad_sch, usb.kicad_sch, vibration.kicad_sch]
2026-01-14 whole bunch of layout done
    [lcd.kicad_sch, power.kicad_sch, usb.kicad_sch, vibration.kicad_sch]
2026-01-18 mcu layout
    [gameboy.kicad_pcb]
2026-01-19 place mcu on board
    [gameboy.kicad_pcb, mcu.kicad_sch]
2026-01-19 add partial power system
    [gameboy.kicad_pcb]
2026-01-19 more routing
    [audio.kicad_sch, gameboy.kicad_pcb, gameboy.step, power.kicad_sch, vibration.kicad_sch]
2026-01-20 route vibration and speaker
    [S2B-PH-SM4-TB.STEP, gameboy.kicad_pcb, vibration.kicad_sch]
2026-01-21 overhaul mcu layout, add last components, stitching vias, run DRC
    [gameboy.kicad_pcb, lcd.kicad_sch]
2026-01-21 hide refs
    [gameboy.kicad_pcb]
2026-01-21 last bit of cleanup
    [gameboy.kicad_pcb]
2026-01-21 change trace cutting zone
    [gameboy.kicad_pcb]
2026-01-21 add lcd model
    [JS202011JCQN.STEP, LCD.step, gameboy.kicad_pcb]
2026-01-21 minor cleanup
    [gameboy.kicad_pcb, gameboy.step, mcu.kicad_sch]
2026-01-23 add silkscreen, optimize layout and replace sd card peripheral
    [SKRRAAE010.stl, SM03B-SRSS-TB_LF__SN_.stp, audio.kicad_sch, gameboy.kicad_pcb, lcd.kicad_sch, mcu.kicad_sch, power.kicad_sch, sd.kicad_sch]
2026-01-23 add invaders
    [gameboy.kicad_pcb]
2026-01-24 change color lcd model, add more teardrops
    [LCD.step, LDC.step, gameboy.kicad_pcb]
2026-01-25 changed size and connectors on the back
    [gameboy.kicad_pcb]
2026-01-25 add power monitoring
    [gameboy.kicad_pcb, gameboy.kicad_sch, mcu.kicad_sch, power.kicad_sch]
2026-01-27 proper lcd backlight driver
    [audio.kicad_sch, gameboy.kicad_pcb, lcd.kicad_sch, power.kicad_sch, vibration.kicad_sch]
2026-01-28 extra capacitance vibration, old backlight method
    [gameboy.kicad_pcb, lcd.kicad_sch, vibration.kicad_sch]
2026-01-30 some small cleanup thingies
    [JS202011JCQN.STEP, LDC.step, SM03B-SRSS-TB_LF__SN_.stp, gameboy.kicad_pcb, gameboy.step, vibration.kicad_sch, wuerth_434133025816.stp]
2026-02-01 changes for production
    [audio.kicad_sch, gameboy.kicad_pcb, lcd.kicad_sch, mcu.kicad_sch, power.kicad_sch, vibration.kicad_sch]
2026-02-01 remove redundant passive lcsc numbers
    [buttons.kicad_sch, gameboy.kicad_pcb]
2026-02-03 fix bom
    [audio.kicad_sch, gameboy.csv, gameboy.kicad_pcb, mcu.kicad_sch, power.kicad_sch, vibration.kicad_sch]
2026-02-03 align some components with inventory
    [buttons.kicad_sch, gameboy.kicad_pcb, lcd.kicad_sch]
2026-02-03 use one lower mlq component
    [mcu.kicad_sch]
2026-02-03 remove references
    [gameboy.kicad_pcb]
2026-02-17 changes after testing the display
    [gameboy.kicad_pcb, lcd.kicad_sch]
2026-02-18 add fiducials and mounting holes
    [gameboy.kicad_pcb, mcu.kicad_sch, power.kicad_sch]
2026-02-18 move capacitor lcd
    [gameboy.kicad_pcb]
2026-05-10 battery polarity and position
    [audio.kicad_sch, buttons.kicad_sch, gameboy.kicad_pcb, gameboy.kicad_sch, lcd.kicad_sch, mcu.kicad_sch, power.kicad_sch, sd.kicad_sch]
2026-05-10 fix lcd connector orientation
    [gameboy.kicad_pcb, lcd.kicad_sch]
2026-05-10 fix on/off switch routing
    [gameboy.kicad_pcb, power.kicad_sch]
2026-05-10 text positioning
    [gameboy.kicad_pcb]
2026-10-02 more switch, change to sideways leds, move battery connector
    [audio.kicad_sch, buttons.kicad_sch, gameboy.kicad_sch, lcd.kicad_sch, mcu.kicad_sch, power.kicad_sch, sd.kicad_sch, usb.kicad_sch]
2026-10-02 change dimention, add back fiducials
    [gameboy.kicad_pcb]
2026-10-02 add user led
    [gameboy.kicad_pcb]
2026-10-02 add user led schematic
    [mcu.kicad_sch]
2026-10-02 move d-pad
    [gameboy.kicad_pcb]
2026-10-02 custom sideways led footprint
    [gameboy.kicad_pcb, mcu.kicad_sch, power.kicad_sch]
2026-10-04 fix bom, add pulldown on amp
2026-10-22 changed amp sd_mode resistor value, move caps, add i2c pullups
